dfrencham/rad-gate/doc/schematic.pdf

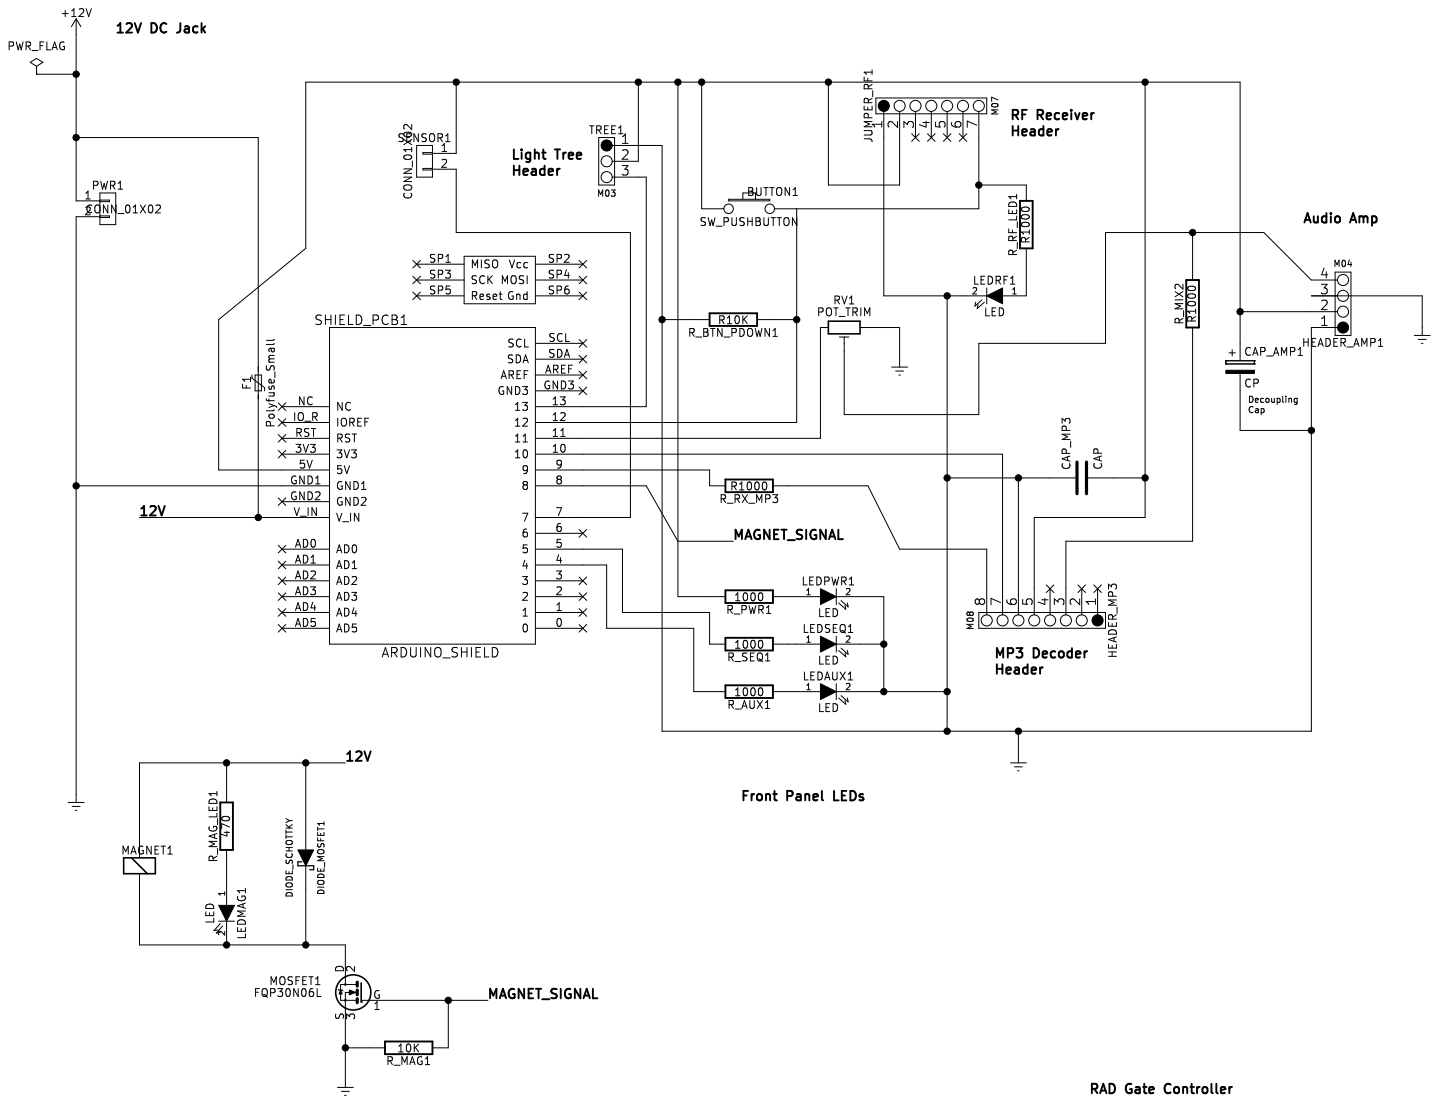
[picture p7: page 1]
