dfrencham/rad-gate/CHANGELOG.md

# Change Log

## 0.7.5
- fixed gate abort interrupt

## 0.7.4
- fixed spelling error in function name

## 0.7.3
- Added mode for controlling relay based light trees

## 0.7.2
- Fixed light tree sequence for cheap NeoPixel stick clones (they seem to use reverse order addressing)

## 0.7.1
- Changed pin assignments to improve circuit board layout

## 0.7.0
- Removed Volume library entirely, added trim pot to design
- switched from relay board to MOSFET

## 0.6.0
- Changed Volume library for Volume3
- Fixed issues with JCQ500 library support
- Added schematic

## 0.5.1
- Added JQ6500 sound module support
- Added RGB light tree support

## 0.5.0
- Fixed C++ bug around object declarations

## 0.4.0
- Refactored from C to C++
- Added makefile
- Released to git hub
