dfrencham/rad-gate/(threads)

Thread 1 (2018-02-13):

Schottky reversed?

lawabb, 2018-02-13:
Hi, Am about to try building your rad-gate.. pretty much as you have outlined. Noticed that the schottky diode looks like it is the wrong way around on the circuit diagram.

dfrencham, 2018-02-13:
Thanks for the heads up, I'll update the diagram.

hwhittington, 2018-02-13:
Good call on the diode, have built the gate and my young lad and his mates love it. (Fortunately I hadn't noticed the diode the wrong way in the drawing and wired it around the right way :), anyway the real intent of this comment is to thank the owner of the project, fantastic work. Very grateful that you shared.

dfrencham, 2018-02-14:
Thanks @hwhittington ! I put my code up because I was amazed that there was no open source BMX gate controller design that I could find - but there seemed to be plenty of people looking for one.

I would love to see pictures of your gate / controller. Here is my current version, with 3d printed case, tripod, and light tree. :)

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

hwhittington, 2018-02-14:
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

hwhittington, 2018-02-14:
Heres some pics of the start gate, fully functional but a bit agricultural :) , Young lad wasn't happy with the gate drop speed so added a bungee cord and alls good. Considered adding a spring but happy with bungee now. Thinking off adding a light beam / timer / LCD display that shows the time from the gate drop to when the rider passes the beam say 25m away. Still a novice with arduino code so that will be fun!

dfrencham, 2018-02-14:
Nothing wrong with agricultural! gives it character.

Here are a couple of pictures of mine... it is built from spare solar panel mounting rails.

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

dfrencham, 2018-02-14:
@hwhittington I've created issue #2 for adding timing, so we can look into it a bit more. If you do want to have a go, I'm happy to review / test the code and merge it into the rad-gate codebase if it works :)

Thread 2 (2018-02-14):

Add timing method

dfrencham, 2018-02-14:
Adding this as a "to-do", as multiple users have requested it now.

**Requirement**

A way to add timing to the gate controller.

- Possibly use a timing mat or light beam set up
- Option to connect LCD

lawabb, 2018-03-05:
Hello dfrencham,
I have added some code to for this ...
Am still waiting for parts from China for our project so only have an Arduino and a frame built at this stage...
Meanwhile I've been hacking your code , mainly to change the way the gate drop works as am going to try a mechanical latch and solenoid  for the gate activation rather than electromagnet.  So sequence.cpp has been changed significantly

 As mentioned,  I've added  another input  for an IR light beam. It triggers a timer that just serial.prints a number in millisecs when triggered at this stage. My idea was to make files  eg ( echo 'seconds' | espeak -w seconds.wav) and save to the JQ6500 (which I don't have yet) and then just announce the result over the speaker. eg saying "two", "point"  "seven" "five" "three" "seconds"

A copy of my code is here. I'm an absolute newbie at Arduino and c++ so there may be some glaring errors,
but is working for me - at least at a breadboard with a few switches and leds level

https://drive.google.com/open?id=1dGuxlN-hSZq61fDu4WuPuBFXC_uE7bwG

Cheers, Lawrie

dfrencham, 2018-03-05:
Hi Lawrie

Arduino / C++ takes a bit of getting used to. I've spent most of my career writing C# - then JS/Typescript. I've got a ton to learn about C++. I've found the using VSCode with the C++ extensions is far, far nicer than using the Arduino IDE. You can install Arduino integration too (but it does call the arduino IDE to do build/deploy). :)

To make it a bit easier to compare/integrate next time, it is best to follow these steps:

- Fork my project
- Use the github client to download the source for your fork
- Create a branch in your fork (Called say, "timing")
- Commit your changes to that branch
- Use the github client to sync your changes with github
- Submit a github pull request

Even if your code is not in a state to merge, it does provide an easy mechanism to compare and comment on code changes. To compare it I had to go through a few extra steps (such as re-adding module dependencies and changing line endings back to Unix format - git will do that automatically if you let it).

I'm reading through your code changes, and will be able to give some feedback in the next 24 hours or so. I really appreciate your efforts - I welcome any potential improvements! :)

You mentioned you are not using a magnet... have you seen this design?
https://www.youtube.com/watch?v=-E_2dcXf4OI

May be similar?

dfrencham, 2018-03-05:
#3

I was about to add a link to the pull request and saw you were already making comments. 👍

Thread 4 (2021-06-22):

Capacitor Values

Pintglass, 2021-06-22:
Hi
Please could you give me an idea as to what values you used for the capacitors on the 5V inputs for the mp3 module and the audio amp.

Thanks

dfrencham, 2021-06-22:
In all honesty I didn't bother using a capacitor and it seems to work ok. Any low value ceramic capacitor should be fine.

hwhittington, 2021-06-23:
I didnt use any caps either, had no issues, gates worked great for a couple of years  now!,

dfrencham, 2021-06-23:
> gates worked great for a couple of years now!,

This is wonderful to hear. :)

Sadly my son has moved on from BMX, so my gate is packed away.

Pintglass, 2021-06-24:
Thanks for that.
Can you tell me what pins on the JQ6500 I should be connecting to from the arduino and is it ok to just upload the two wav files to the JQ6500 as I'm not getting any spoken voice.

dfrencham, 2021-06-24:
To upload the wav files you will need to use the MusicDownloader program linked on this page: https://sparks.gogo.co.nz/jq6500/index.html

For connecting the JQ6500, using the diagram on the page linked above:

- RX -> Arduino D10
- TX -> Arduino D9 (with 1000ohm resistor between)
- DAC_L  (left channel) -> Amp input
- GND (under TX) -> ground
- VCC -> power input, 5v

Here is my PCB:

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

Pintglass, 2021-06-24:
Thanks for the help but
Sorry I'm a little confused now, in your text your saying the RX on the JQ6500 goes to pin 10 on the arduino, but on your circuit board you have pin 10 on the arduino connected to TX on the JQ6500
