dfrencham/rad-gate/(commit log)

2017-03-05 Switched to Volume3, added schematic
2017-04-13 Updated pin out
    Switched to MOSFET, added trim pot, fixed audio interference.
    [AudioFX.cpp, AudioFX.h, Gate.cpp, Sequence.cpp, constants.cpp, constants.h, rad-gate.ino]
2017-04-13 Updated schematic
2017-04-17 Fix light order for cheap neo pixel clones
    [LightTree.cpp]
2017-10-30 Added sound samples
2017-11-02 Added relay control mode for light tree
2017-12-19 Fixed abort interrupt handler
    [Gate.cpp, LightTree.cpp, Sequence.cpp, constants.h, rad-gate.ino]
